keebio/fourier/(commit log)

2019-01-28 Copy old project into new one
    Update license and readme
    [fourier.kicad_pcb, fourier.sch]
2019-01-28 Fourier 1.0
    [fourier-right.kicad_pcb, fourier-right.sch, fourier.kicad_pcb, fourier.sch]
2019-01-28 Add mounting holes to left side
    [fourier.kicad_pcb]
2019-01-28 Add mounting holes to right side
    [fourier-right.kicad_pcb]
2019-01-28 Split left and right files into their own directories/projects
    [fourier-left.kicad_pcb, fourier-left.sch, fourier-right.kicad_pcb, fourier-right.sch]
2019-01-28 Add top/bottom plates
    [fourier-left-bottom.kicad_pcb, fourier-left-top.kicad_pcb, fourier-left.kicad_pcb, fourier-left.sch, fourier-right-bottom.kicad_pcb, fourier-right-top.kicad_pcb]
2019-01-28 Added 1u support on bottom-left, stepped 1.25u support on right half
    [fourier-left-top.kicad_pcb, fourier-left.kicad_pcb, fourier-left.sch, fourier-right-top.kicad_pcb, fourier-right.kicad_pcb, fourier-right.sch]
2019-01-28 Fix left top plate to support 4x1u layout
    [fourier-left-top.kicad_pcb]
2019-01-28 Move B7 to different location to give room for Mini-USB Pro Micro
    [fourier-right.kicad_pcb]
2019-01-28 Move VCC pad down
    [fourier-right.kicad_pcb]
2019-01-28 Bring in edge cuts to allow for better fit in case
    [fourier-right.kicad_pcb]
2019-01-28 Move C1 diode to give room for Mini-USB Pro Micro
    [fourier-left.kicad_pcb]
2019-01-28 Bringing in edge cuts
    [fourier-left.kicad_pcb]
2019-01-28 Update Fourier logo to 1.2
    [fourier-left.kicad_pcb]
2019-01-28 Update footprints
    [fourier-left.kicad_pcb, fourier-left.sch, fourier-right.kicad_pcb, fourier-right.sch]
2019-01-28 Add 1/1.25u inner key option
    [fourier-left.kicad_pcb, fourier-left.sch, fourier-right.kicad_pcb, fourier-right.sch]
2019-01-28 Add a bunch of stuff, don't remember what it was
    [fourier-left.kicad_pcb, fourier-left.sch, fourier-right.kicad_pcb]
2019-01-28 Fix TRRS jack for left side, use staggered Pro Micro
    [fourier-left.kicad_pcb, fourier-left.sch]
2019-01-28 Right side - fix TRRS jack, switch to staggered Pro Micro
    [fourier-right.kicad_pcb, fourier-right.sch]
2019-01-28 Route GND pads together
    [fourier-left.kicad_pcb, fourier-left.sch, fourier-right.sch]
